qrp73/ali_trx/pictures/AD6645-14bit-105MHz-module.jpg

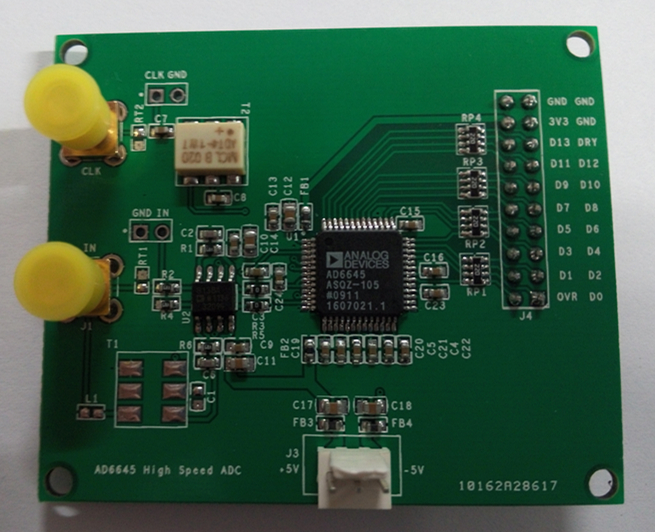
pictures/AD6645-14bit-105MHz-module.jpg
