qrp73/ali_trx/pictures/ADT4-1WT.jpg

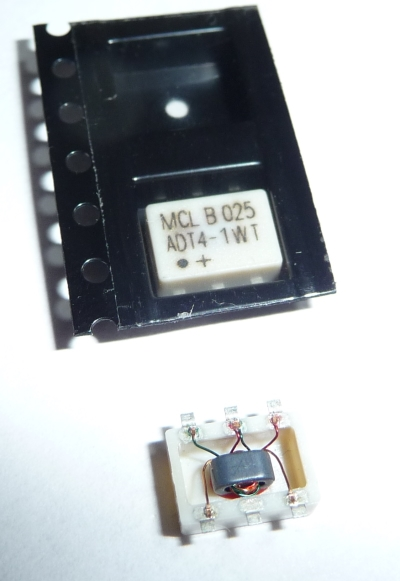
pictures/ADT4-1WT.jpg
