qrp73/ali_trx/pictures/ATT-6dB.jpg

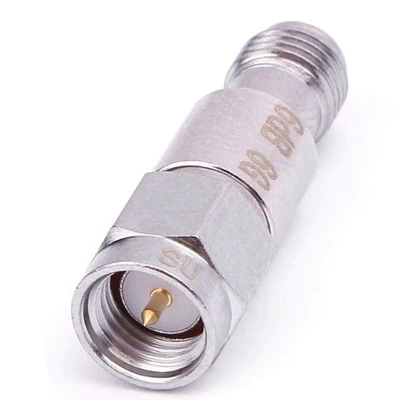
pictures/ATT-6dB.jpg
