qrp73/ali_trx/pictures/DAC904-14-bit-165MHz-module.jpg

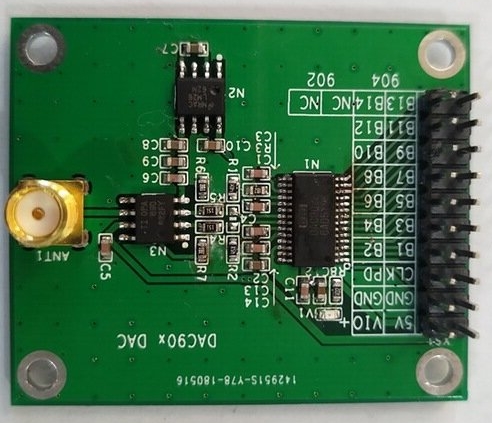
pictures/DAC904-14-bit-165MHz-module.jpg
