qrp73/ali_trx/pictures/EP4CE22E22C8N-fpga-development-board.jpg

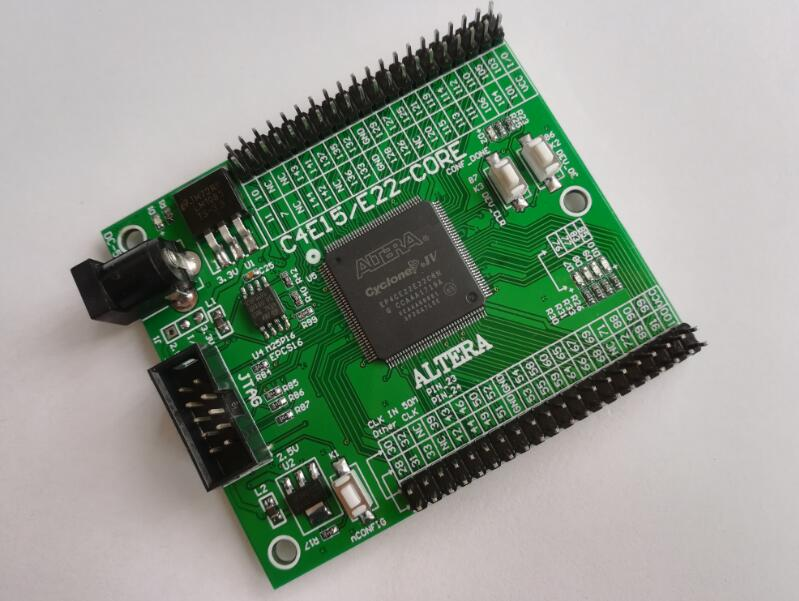
pictures/EP4CE22E22C8N-fpga-development-board.jpg
