qrp73/ali_trx/pictures/HEATSINK-AD6645.jpg

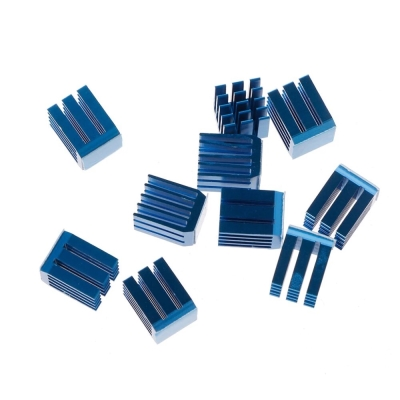
pictures/HEATSINK-AD6645.jpg
