qrp73/ali_trx/pictures/LAN8720-PHY-RMII-Interface-module.jpg

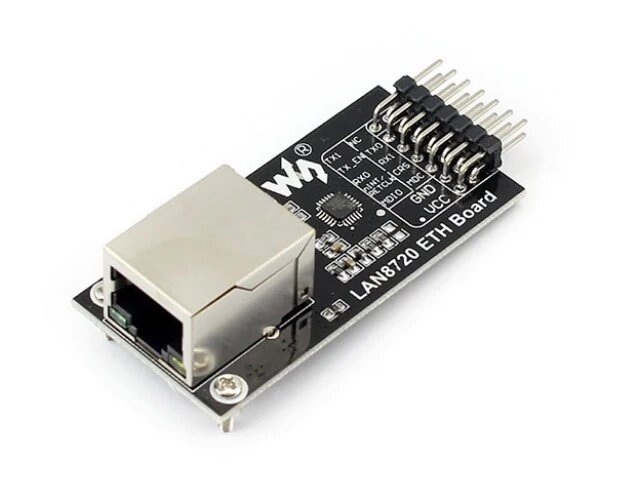
pictures/LAN8720-PHY-RMII-Interface-module.jpg
