qrp73/ali_trx/pictures/LPF-390-470-real.png

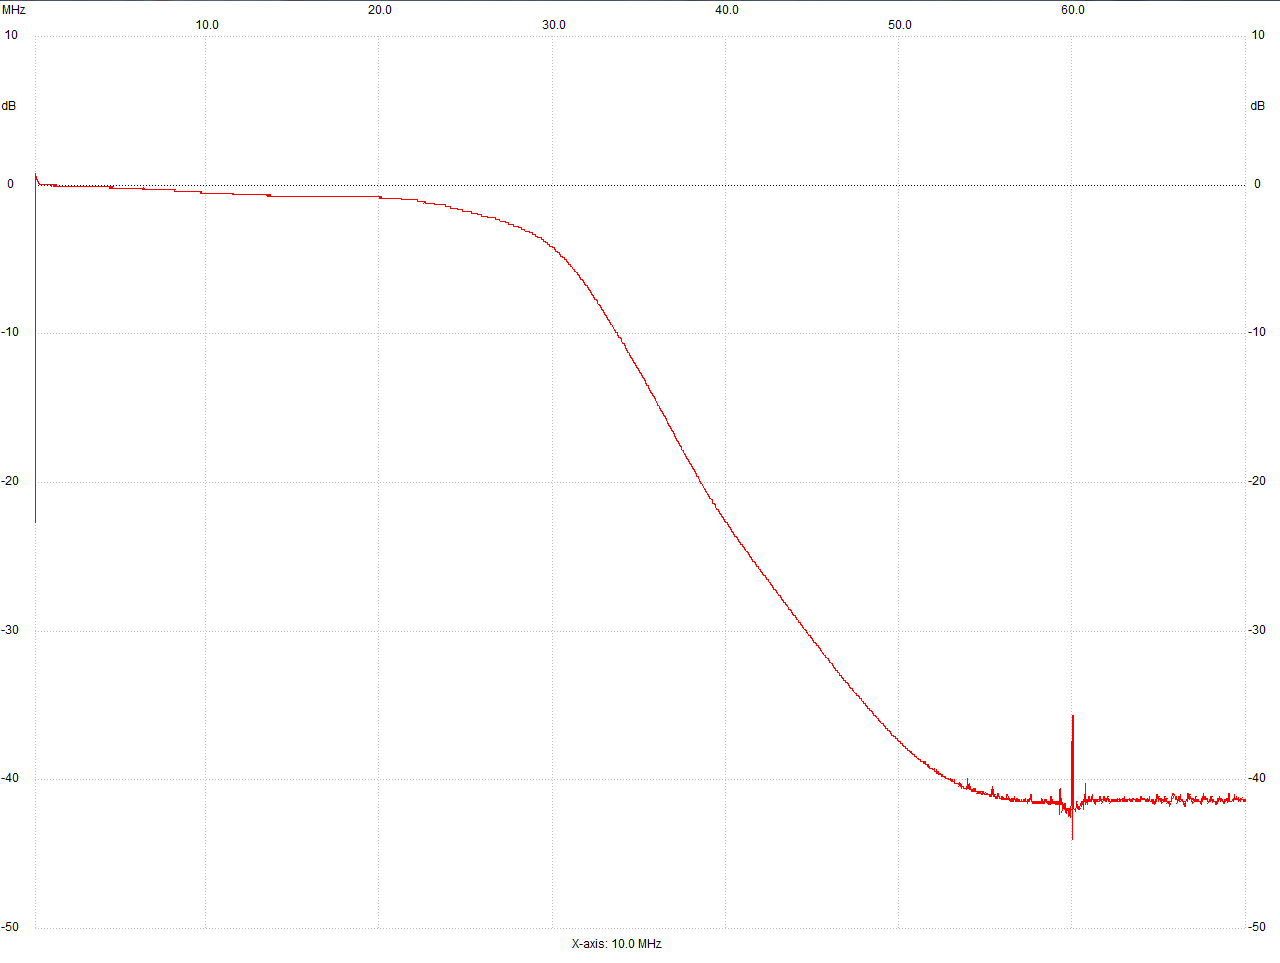
pictures/LPF-390-470-real.png
