qrp73/ali_trx/pictures/TCXO-96MHZ-DIP4.jpg

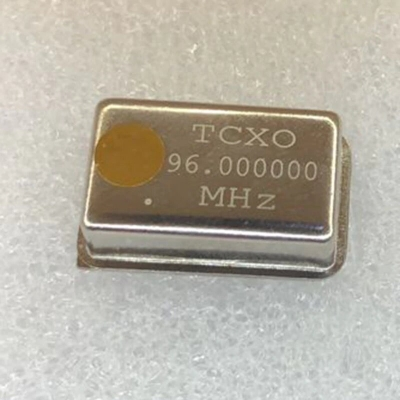
pictures/TCXO-96MHZ-DIP4.jpg
