qrp73/ali_trx/pictures/WM8731-module.jpg

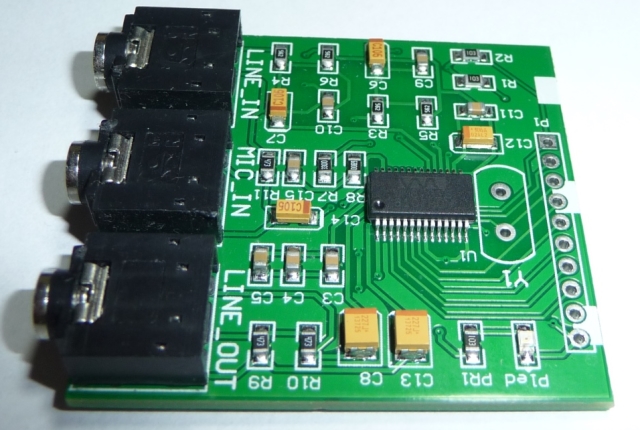
pictures/WM8731-module.jpg
