qrp73/ali_trx/(threads)

Thread 1 (2022-04-23):

Copy project

UN7RX, 2022-04-23:
Your project is 100% copied [from here](http://www.cqham.ru/forum/showthread.php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). Why didn't you name the author?

qrp73, 2022-06-24:
No, you're wrong, my project is a clone of [Hermes-Lite project]([Hermes-Lite](https://github.com/softerhardware/Hermes-Lite)).

The original Hermes-lite project fork which I was used for a clone is a GNU licensed project which author is [Steve Haynal](https://github.com/softerhardware). His original copyright with the author name is included in my clone.

By the way, this Hermes-lite clone is actually very outdated and has some issues, because I made it when I was a novice in FPGA design and didn't know about many things, such as metastability and clock synchronization. There was some updates and fixes, but I just abandoned that project, because it has a lot of issues. After that I also worked on Hermes-lite-2 clone and rewrote all DSP code, but later I was needed for a higher bandwidth and just decided to abandon that project, because it uses HPSDR protocol which has too many overhead.

Currently I'm working on a complete new gateware for DDC receiver which is designed from scratch. I replaced 100M PHY with 1G GMII PHY controller. And now I'm using ethernet UDP stack written by [Alex Forencich](https://github.com/alexforencich), thanks to Steve Haynal for his recommendation. It use 1G ethernet speed.

Also there is a complete new DSP code, I'm using a new NCO with better spurious performance, also I implemented a new filters calculated in MATLAB with much better dynamic range. So the total performance now is better, my new DDC has less spurs, less signal processing noise.

Also I'm working on a PC software for my DDC which utilize GPU acceleration, Currently it has Direct2D renderer, but I'm planning to move it to OpenGL and to implement fosphor feature, like [this one](https://www.youtube.com/watch?v=mjD-l3GAghU).

qrp73, 2022-06-24:
If you're interested, here is response of the FIR filter used in this hermes-lite clone (it also used in other OpenHPSDR open source projects) and for comparison response of my new FIR. In addition to that dynamic range improvements, I also using a new NCO and CIC implementation to eliminate some spurs.

The blue is a CIC filter response, the green is a FIR filter response and the red is a combined CIC+FIR response.

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

Closed 2022-06-24.
