qrp73/ali_trx/(commit log)

2019-01-19 fix ADC overflow handling; minor cleanup
    [audio_i2s.v, hermes_lite_core.v, mic_i2s.v]
2019-01-21 add ultra low noise power supply module to the list
